xtech/hw-openmower-yardforce/components/nlbn/NLBN-TL;DR.md

# About

Fast and reliable EasyEDA/LCSC to KiCad converter with batch processing support

https://docs.rs/crate/nlbn

# Install

cargo install nlbn

# Usage

`~/.cargo/bin/nlbn --full --lcsc-id C4711`
