xtech/hw-openmower-yardforce/3d/FuseClip.stp

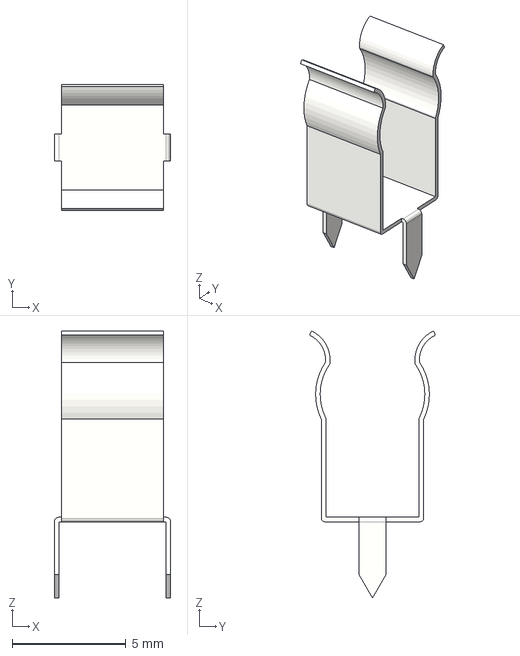
[picture p2: CAD file, 2024-09-19]
3d/FuseClip.stp
5.10 x 5.53 x 11.7 mm
