xtech/hw-openmower-yardforce/components/extern/3dmodels/Connectors/USB2.stp

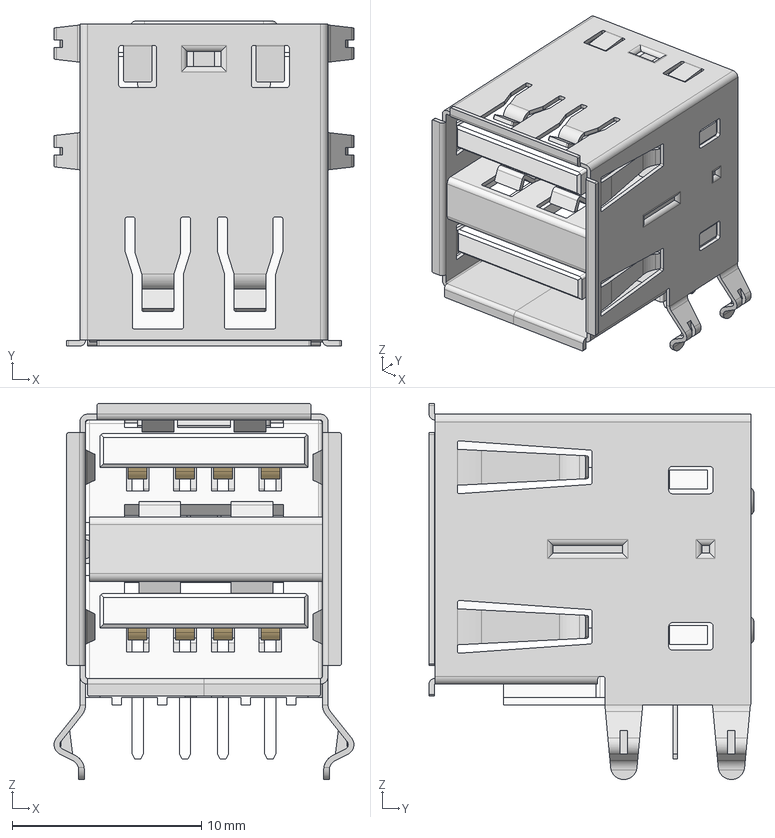
[picture p4: CAD file, 2024-09-19]
components/extern/3dmodels/Connectors/USB2.stp
15.8 x 17.1 x 19.8 mm
61400826021_Shielding1
61400826021_Housing
61400826021_Shielding2
61400826021_Pin2 x 4
61400826021_Pin1 x 4
61400826021_Shielding3
