xtech/hw-openmower-yardforce/components/extern/3dmodels/Connectors/USB3.stp

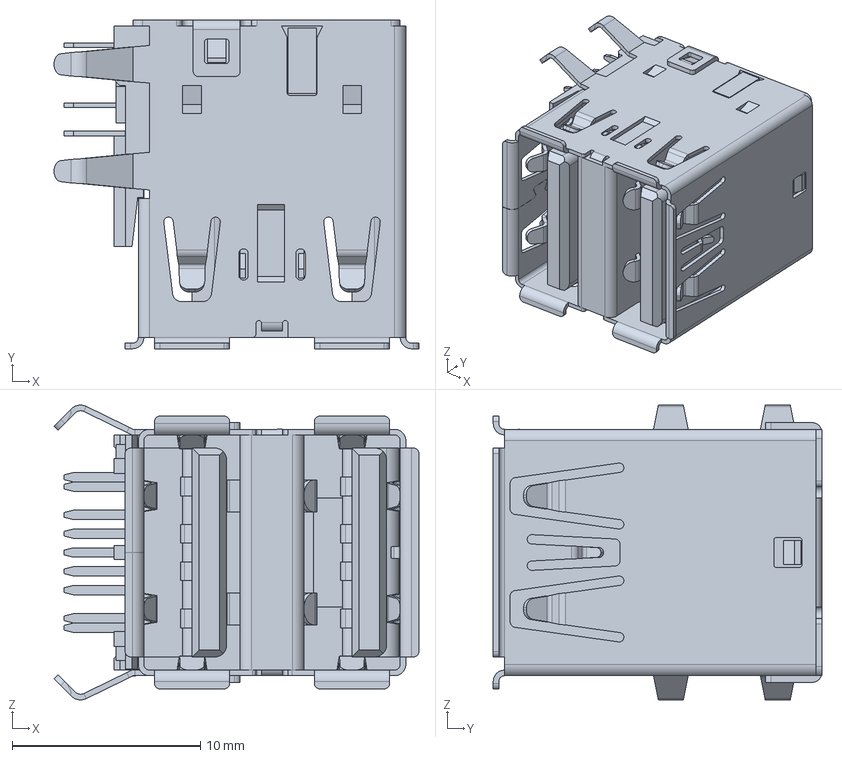
[picture p5: CAD file, 2024-09-19]
components/extern/3dmodels/Connectors/USB3.stp
19.4 x 17.5 x 15.7 mm
