xtech/hw-openmower-yardforce/3d/039281023_stp/039281023.stp

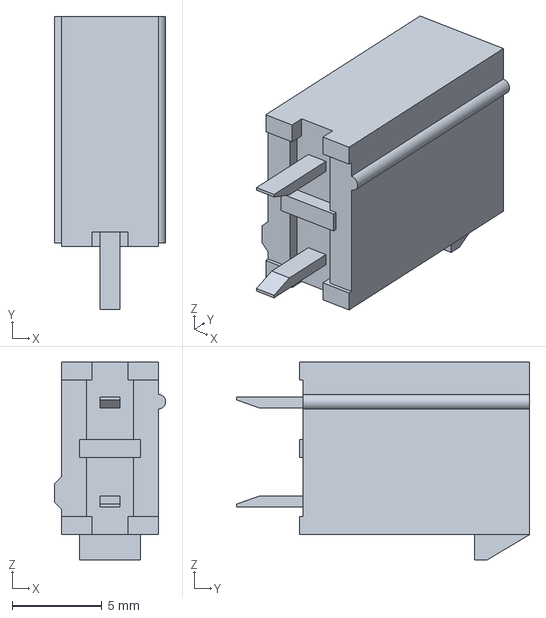
[picture p7: CAD file, 2024-09-19]
3d/039281023_stp/039281023.stp
6.20 x 16.3 x 11.0 mm
