xtech/hw-openmower-yardforce/3d/039281223_stp/039281223.stp

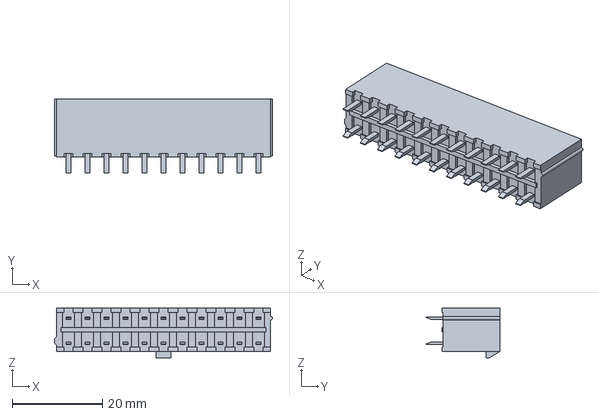
[picture p9: CAD file, 2024-09-19]
3d/039281223_stp/039281223.stp
48.2 x 16.3 x 11.0 mm
