xtech/hw-openmower-yardforce/3d/LM76005RNPR.stp

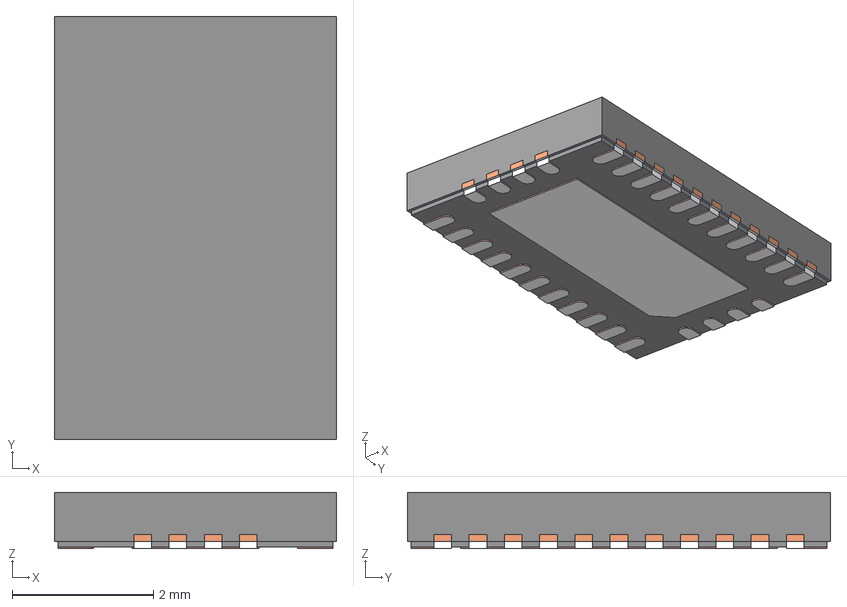
[picture p10: CAD file, 2024-09-19]
3d/LM76005RNPR.stp
4.00 x 6.00 x 0.8 mm
BODY-QFN_AF0
FRAME-RNP0030B_AF0
PIN1-ID
