xtech/hw-openmower-yardforce/components/extern/3dmodels/local_Connectors/HR911130A.step

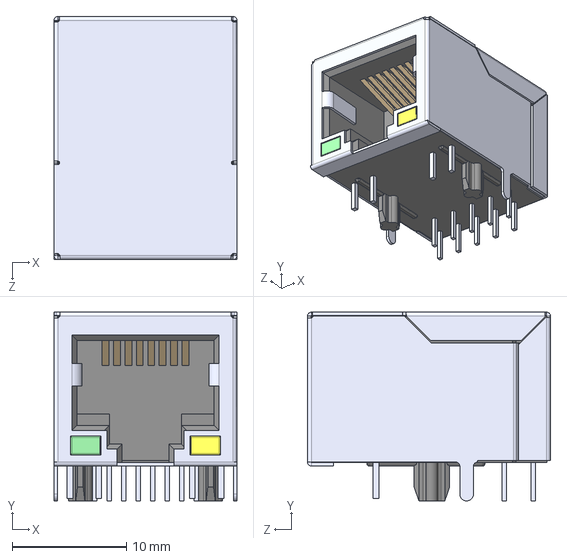
[picture p12: CAD file, 2024-09-19]
components/extern/3dmodels/local_Connectors/HR911130A.step
16.0 x 16.6 x 21.3 mm
