xtech/hw-openmower-yardforce/components/extern/3dmodels/local_DCDC/LM76005RNPR.step

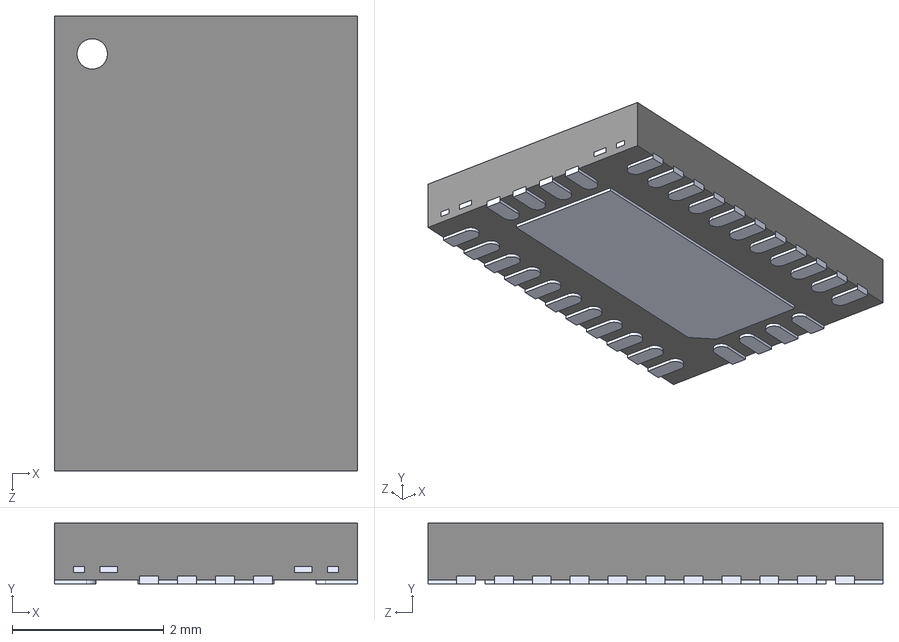
[picture p13: CAD file, 2024-09-19]
components/extern/3dmodels/local_DCDC/LM76005RNPR.step
4.00 x 0.8 x 6.00 mm
