xtech/hw-openmower-yardforce/(threads)

Thread 3 (2025-06-17):

Fan improvements

ClemensElflein, 2025-06-17:
Silkscreen für den 5V, 12V Dupont und den selectable Molex Anschluss (hier dann ein pfeil oder dicke warnung zum voltage select)
bitte eine Möglichkeit zwischen 5V und 12V (und 24V haben wir nicht sondern nur vbat richtig?) für den Molex fan aufm yf wählen kann

Closed 2025-06-17.
