xtech/hw-openmower-yardforce/(commit log)

2024-09-20 Fixed resistor values, small changes
    [Amplifier.kicad_sch, AuxPSU.kicad_sch, Charger.kicad_sch, Connectors.kicad_sch, Core.kicad_sch, DCDC.kicad_sch, GPS.kicad_sch, RobotConnectors.kicad_sch]
2024-09-20 added D3, fixed 3d model
    [RobotConnectors.kicad_sch]
2024-09-21 updated UM9XX footprint, added enable pin for UMXX
    [GPS.kicad_sch, hw-openmower-yardforce.kicad_sch]
2024-09-22 Added FET to disable the UM9XX GPS module when idle
    [GPS.kicad_sch, hw-openmower-yardforce.kicad_sch]
2024-09-26 updated schematic
    [Core.kicad_sch]
2024-09-28 updated gate charger resistor value
    [Amplifier.kicad_sch, AuxPSU.kicad_sch, Charger.kicad_sch, Connectors.kicad_sch, Core.kicad_sch, DCDC.kicad_sch, GPS.kicad_sch, RobotConnectors.kicad_sch]
2024-10-12 Added bias supply to DCDC for improved efficiency
    [DCDC.kicad_sch]
2024-10-13 Updated xcore library
    [Core.kicad_sch]
2024-10-19 Added power switch for F9P
    [Core.kicad_sch, GPS.kicad_sch]
2025-06-17 Added voltage selector for fans, added silkscreen for fan connectors (fixes #3)
    [hw-openmower-yardforce.kicad_sch]
2025-06-18 Added silkscreen
2025-06-18 Removed third FAN connector, improved silkscreen docs
    [hw-openmower-yardforce.kicad_sch]
2025-06-18 Use AGPIO on extension headers
    [hw-openmower-yardforce.kicad_sch]
2025-06-19 Added Fuses
    [RobotConnectors.kicad_sch]
2026-05-30 Make ERC happy
    [Amplifier.kicad_sch, AuxPSU.kicad_sch, Charger.kicad_sch, Connectors.kicad_sch, Core.kicad_sch, DCDC.kicad_sch, GPS.kicad_sch, RobotConnectors.kicad_sch]
2026-05-30 DNP 12V Aux XT60 plug
    [hw-openmower-yardforce.kicad_sch]
2026-05-30 Compact charger for USB move
    [Charger.kicad_sch]
2026-05-30 Fix USB socket placement
2026-05-31 Add USB 3D via nlbn
    [Connectors.kicad_sch]
2026-06-01 Fix V_CHARGE ADC
    [RobotConnectors.kicad_sch]
2026-06-01 Fix V_BATT ADC
    [RobotConnectors.kicad_sch]
2026-06-01 V_BATT TVS protection
    [xESC.kicad_sch]
2026-06-01 V_CHARGE TVS protection and V_CHARGE ADC divider adjustment
    [RobotConnectors.kicad_sch]
2026-06-07 Add Robot-Adapter and OEM plugs WIP
    [Amplifier.kicad_sch, Connectors.kicad_sch, RobotConnectors.kicad_sch, hw-openmower-yardforce.kicad_sch]
2026-06-07 Finished generic routing
    [RobotConnectors.kicad_sch]
2026-06-08 Make OEM Buttons 5V tolerant
    [RobotConnectors.kicad_sch, hw-openmower-yardforce.kicad_sch]
2026-06-08 GPS mount holes and silk
    [GPS.kicad_sch]
2026-06-08 F-Silk & IDC-OEM 5V
2026-06-09 Enlarge mow phases and VBat from power plug
2026-06-09 Updated workflow to KiCAD 9
2026-06-09 Fix BOM and switch C0402 to C0603
    [Amplifier.kicad_sch, Charger.kicad_sch, Connectors.kicad_sch, Core.kicad_sch, DCDC.kicad_sch, GPS.kicad_sch, RobotConnectors.kicad_sch, hw-openmower-yardforce.kicad_sch]
2026-06-09 Switch R0402 to 0603
    [AuxPSU.kicad_sch, Charger.kicad_sch, Connectors.kicad_sch, Core.kicad_sch, GPS.kicad_sch, RobotConnectors.kicad_sch]
2026-06-09 Finished BOM
2026-06-10 Improve GND current via wider heat trap width
2026-06-10 Fix BOM and parts placement
    [Amplifier.kicad_sch, AuxPSU.kicad_sch, Charger.kicad_sch, Core.kicad_sch, RobotConnectors.kicad_sch, hw-openmower-yardforce.kicad_sch]
2026-06-10 Final part rotations
    [Connectors.kicad_sch, GPS.kicad_sch]
2026-07-20 Improved Charger Silk (Fixes #17)
2026-07-20 EEPROM header now DNP (Fixes #16)
    [Core.kicad_sch]
2026-07-20 Replaced stacked USB-A header with a single one (Fixes #15)
    [Connectors.kicad_sch]
2026-07-20 Added filter to VBATT and VCHARGE rails, increased cap to 470nF, moved cap close to xCore (fixes #14)
    [RobotConnectors.kicad_sch]
2026-07-20 Increased hole size for MMCX connector (fixes: #13)
2026-07-20 Added DRC exclusion for resistor below GPS. Removed thermal relief fill below DCDC
